rjitender/solar-iv-tracer/iv_curve.png

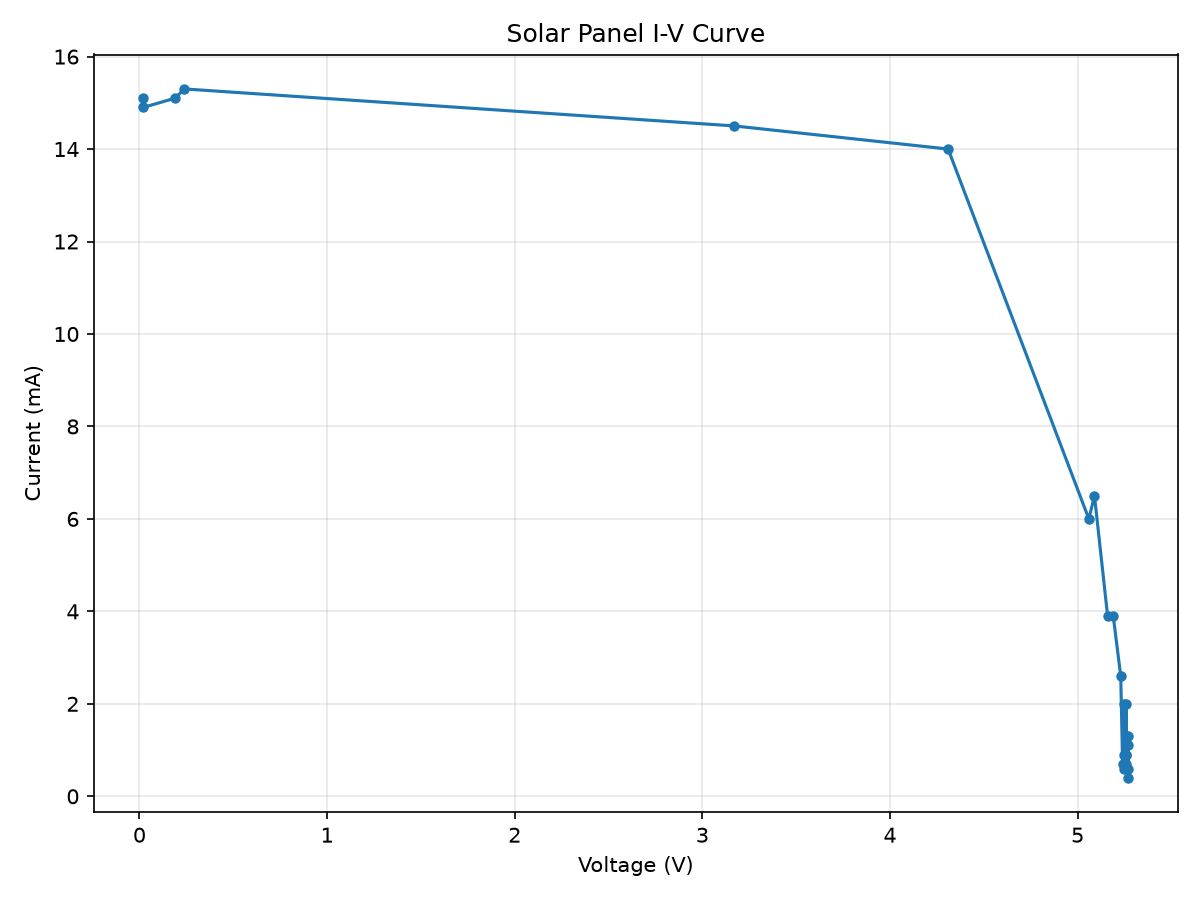
iv_curve.png
