rjitender/solar-iv-tracer/iv_curve_fit.png

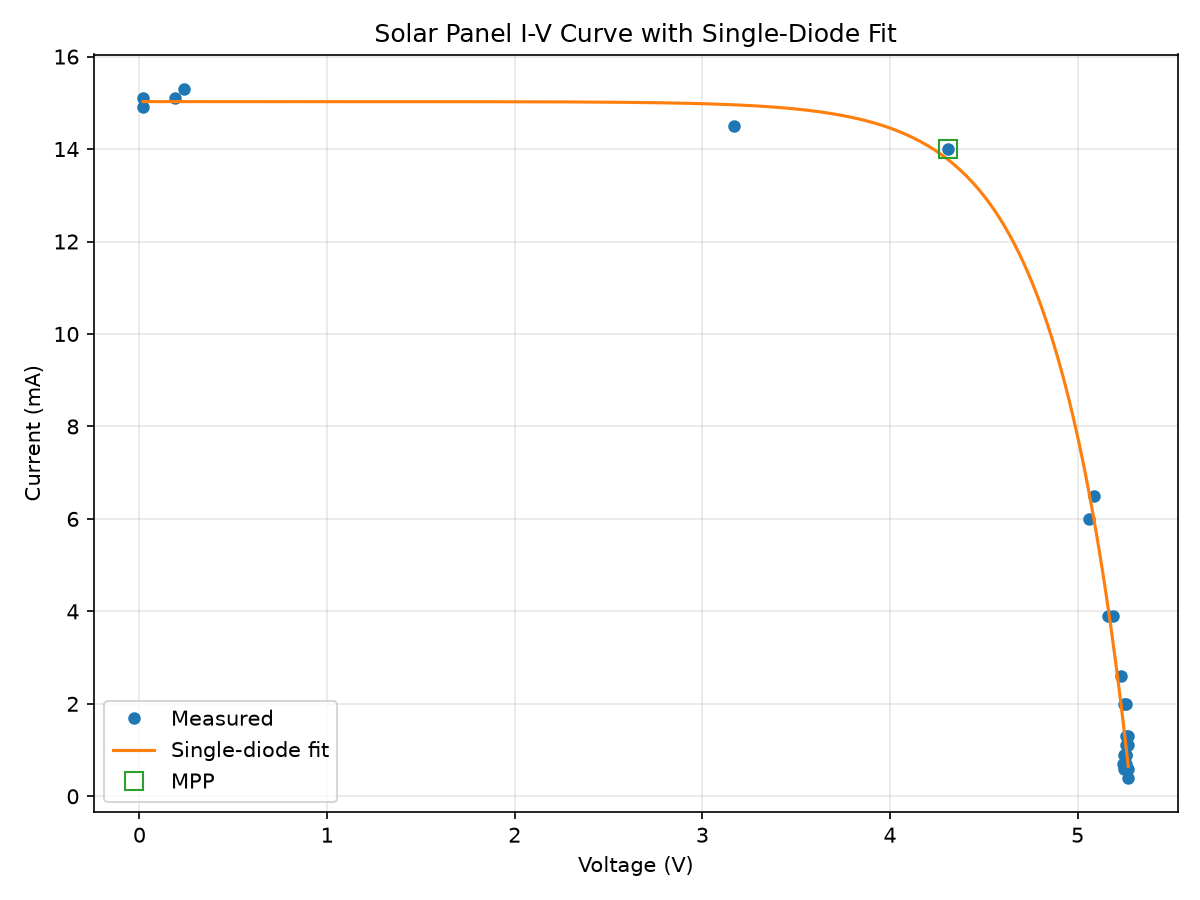
iv_curve_fit.png
