rjitender/solar-iv-tracer/iv_residuals_v2.png

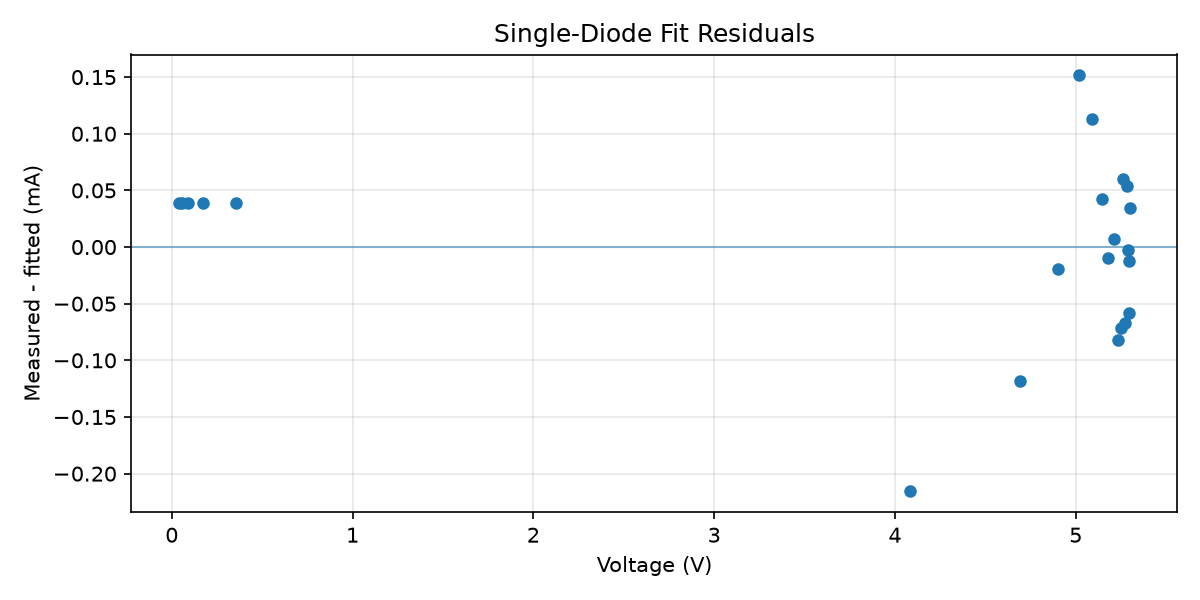
iv_residuals_v2.png
