rjitender/solar-iv-tracer/sensor_stuff/sensor_plot_clean.png

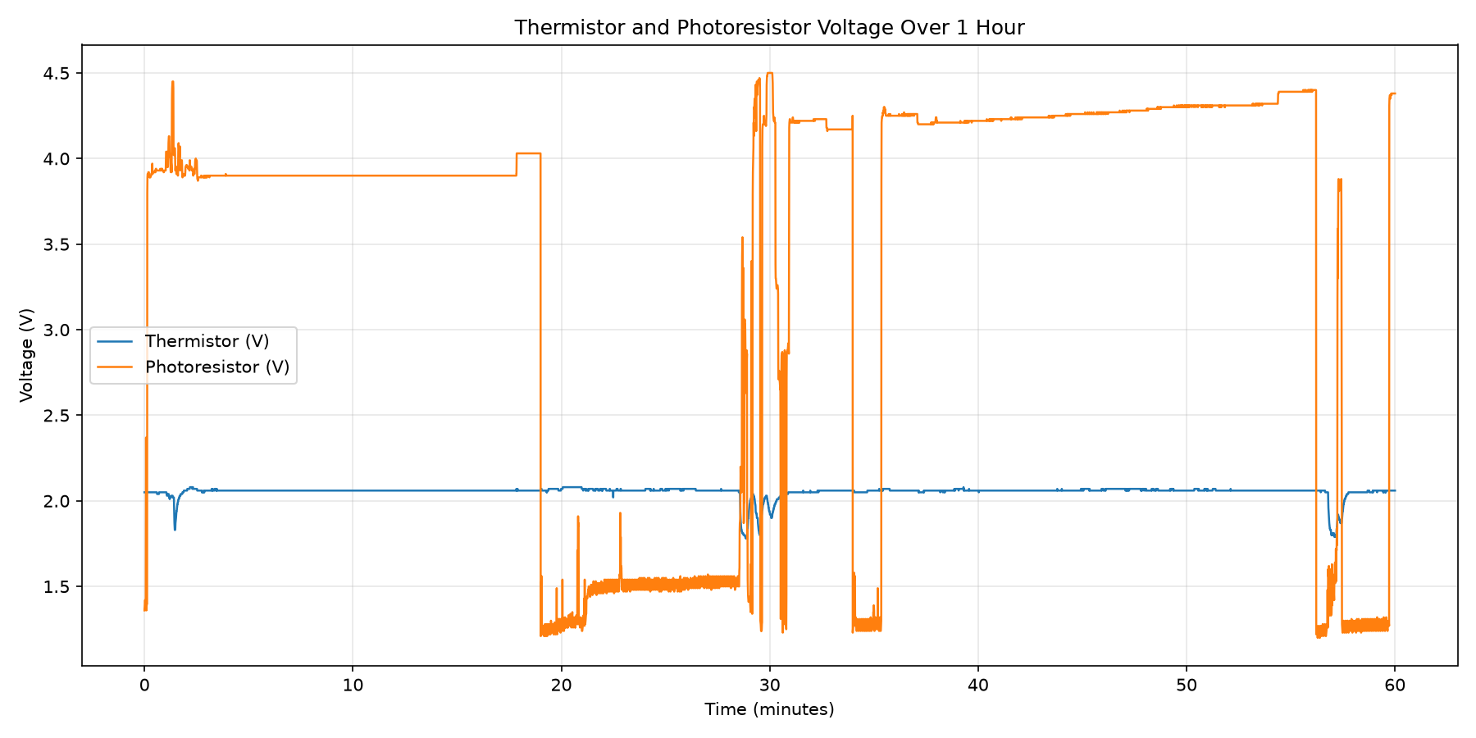
sensor_stuff/sensor_plot_clean.png
