rjitender/solar-iv-tracer/iv_sweep_v2_step1.csv

duty_cycle | voltage_v | current_mA
0 | 5.332 | 0.0
1 | 5.332 | 0.0
2 | 5.332 | 0.0
3 | 5.332 | 0.0
4 | 5.332 | 0.0
5 | 5.332 | 0.0
6 | 5.332 | 0.0
7 | 5.332 | 0.0
8 | 5.332 | 0.0
9 | 5.328 | 0.0
10 | 5.328 | 0.0
11 | 5.328 | 0.0
12 | 5.328 | 0.0
13 | 5.328 | 0.0
14 | 5.328 | 0.0
15 | 5.328 | 0.0
16 | 5.328 | 0.0
17 | 5.328 | 0.0
18 | 5.328 | 0.0
19 | 5.328 | 0.0
20 | 5.328 | 0.0
21 | 5.328 | 0.0
22 | 5.328 | 0.0
23 | 5.328 | 0.0
24 | 5.328 | 0.0
25 | 5.328 | 0.0
26 | 5.324 | 0.0
27 | 5.328 | 0.0
28 | 5.324 | 0.0
29 | 5.324 | 0.0
30 | 5.324 | 0.0
31 | 5.324 | 0.0
32 | 5.324 | 0.0
33 | 5.324 | 0.0
34 | 5.324 | 0.0
35 | 5.324 | 0.0
36 | 5.324 | 0.0
37 | 5.324 | 0.0
38 | 5.324 | 0.0
39 | 5.324 | 0.0
40 | 5.324 | 0.0
41 | 5.324 | 0.0
42 | 5.324 | 0.0
43 | 5.324 | 0.0
44 | 5.324 | 0.0
45 | 5.324 | 0.0
46 | 5.324 | 0.0
47 | 5.324 | 0.0
48 | 5.324 | 0.0
49 | 5.324 | 0.0
50 | 5.32 | 0.0
51 | 5.32 | 0.0
52 | 5.32 | 0.0
53 | 5.32 | 0.0
54 | 5.32 | 0.0
55 | 5.32 | 0.0
56 | 5.32 | 0.0
57 | 5.32 | 0.0
58 | 5.32 | 0.0
59 | 5.32 | 0.0
60 | 5.32 | 0.0
61 | 5.32 | 0.0
62 | 5.32 | 0.0
63 | 5.32 | 0.0
64 | 5.32 | 0.0
65 | 5.32 | 0.0
66 | 5.32 | 0.0
67 | 5.32 | 0.0
68 | 5.32 | 0.0
69 | 5.316 | 0.0
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
