rjitender/solar-iv-tracer/(commit log)

2026-07-14 Session 1: sensortools.py summarize function, venv
2026-07-17 Live sensor logging: Arduino CSV output, pyserial logger, dedupe fix for sleep-induced duplicate timestamps, pandas/matplotlib plot. Photoresistor variation traced to room light switching.
    [sensor_log.csv, sensor_log_clean.csv]
2026-07-17 Added small details to the sensor readings graph: seconds to minutes on the x-axis and updating the title.
2026-08-06 Tracer v1: full I-V sweep captured
    Fixed floating ground issue - INA219 bus voltage read as 0 until the panel/pot loop's negative side was tied to the shared Arduino/INA219 ground reference (current, measured differentially across the shunt, was unaffected). Built sweep_logger.py for manual keypress-triggered logging. Captured ~30 point sweep from Voc (~5.27V) through the knee to Isc (~15.1mA), with extra points logged around the sharp transition. Last data point likely affected by clouds - voltage and current both dropped together, inconsistent with the rest of the sweep.
    [iv_sweep.csv]
2026-08-07 Single-diode model fit and full device characterization
    Extracted Voc 5.27V, Isc 15.1mA, MPP 60.34mW at 4.31V, fill factor 0.758. Fitted ideal single-diode model via scipy curve_fit: I_L 15.03mA (matches measured Isc), I_0 2.2e-8 A, n_eff 15.20 across 10 series cells giving n_cell 1.52. First fit attempt diverged - single-cell initial guess for n caused exponential overflow, since the panel is a 10-series-by-2-parallel module. Fixed by fitting log10(I_0) for conditioning, adding physical bounds, and seeding n from a two-point hand calculation. Model has no series or shunt resistance; R_s shows no visible effect at these currents, and R_sh is under-constrained by the sparse near-Isc sampling.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
    [iv_sweep.csv, sensor_log.csv, sensor_log_clean.csv]
2026-08-08 v2 automated sweep: mechanically working, fit does not converge
    MOSFET/PWM sweep runs end-to-end and produces the right overall trend (Isc ~16.6mA to Voc ~5.26V), but individual points show zigzag rather than a smooth curve. Root cause: PWM gate drive isn't fully DC, so duty-cycle steps can produce out-of-order voltage readings; sorting by voltage for the fit then connects points that weren't adjacent in time, turning noise into curve distortion. Three-parameter fit puts n at its upper bound (30.0) and I_L undershoots measured Isc by ~40%, versus v1's <0.5% agreement, showing the optimizer is fitting noise. Debugged and ruled out along the way: I2C hang at a specific duty cycle traced to a s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
    [iv_sweep_v2.csv]
2026-08-12 v2 load circuit: root-cause diagnosis after many failed capacitor iterations, Phase 1 fix applied
    Every attempt to clean up the v2 sweep by treating it as a noise problem
    failed the same way: n pinned at its fit bound, the I_L undershot measured
    Isc by 30-40%, regardless of capacitor value (1, 2.25, 4.75, 10uF) or whether
    readings were averaged by mean or median. Many iterations across a few days
    kept producing the same failure, which led me to start questioning the hardware itself.
    Stepped back, did a lot of research, and worked through the RC math for the gate network:
    T/tau at 490 Hz PWM with a 215-ohm gate resistance and any cap in
    the 1-10uF range works out to roughly 1, meaning t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
    [iv_sweep_v2.csv]
2026-08-12 v2: parasitic oscillation confirmed and fixed at MOSFET load transition; new fit failure is unrelated (illumination drift)
    Two separate findings today:
    FIXED: reproducible spike at duty~117-118 (see spike data folder for data)
    Two prior clean-light runs both showed the same anomaly at the same duty
    value (26.9mA and 24.3mA spikes against a ~8-13mA trend, always right at
    the edge of the responsive window before full saturation). It was reproducible
    enough to rule out random sensor noise. Suspected parasitic oscillation
    from gate-drain capacitance interacting with breadboard lead inductance,
    since that region sits right at the load's transition into saturation.
    Held the sketch at duty=118 an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
    [iv_sweep_v2_step1.csv, iv_sweep_v2_step1_1.csv]
2026-08-13 v2: first fully converged, monotonic sweep
    Same hardware as last night's commit (drain-source oscillation fix,
    relocated gate resistor), re-run this morning in strong, steady light
    before clouds could interfere.
    monotonicity: 0 violations across 21 steps, worst deviation -4mV
    (inside sensor noise)
    fit: converged with no parameters on a bound
    residuals: scattered +/-0.15mA with no slope near either end -
    the 3-parameter model is sufficient, no case for adding Rs/Rsh yet
    Isc: 15.50 mA
    Voc: 5.30 V
    MPP: 4.08 V, 14.50 mA, 59.22 mW
    Fill Factor: 0.721
    I_L: 15.46 mA (0.3% of measured Isc - tightest agreement yet)
    I_0: 3.118e-08 A
    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
    [iv_sweep_v2_step1.csv, iv_sweep_v2_step1_1.csv]
